tkuester/public-safety-lna/lna-filt.kicad_pcb

## KiCad design lna-filt.kicad_pcb (2020-05-25)

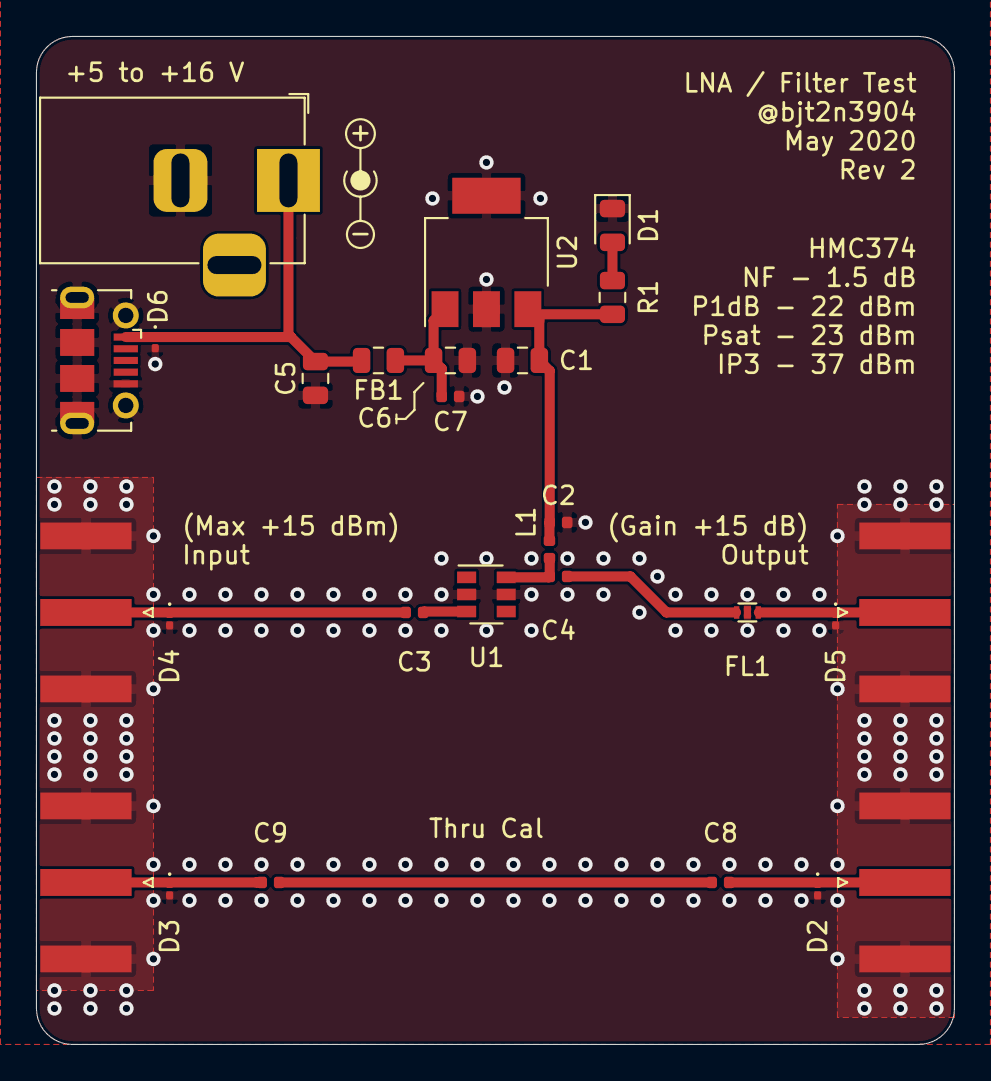
[picture p2: board lna-filt.kicad_pcb from above]

Board: 2 copper layers, 51.0 x 56.0 mm, 27 parts (0 on the bottom side), 13 nets.

Parts:
C1, C5, C6: 4.7u; C_0805_2012Metric
C2: 1n; C_0402_1005Metric
C3, C4, C8, C9: 150p; C_0402_1005Metric
C7: 100n; C_0402_1005Metric
D1: LED; LED_0805_2012Metric
D2, D3, D4, D5, D6: ESD101; D_0201_0603Metric
FB1: Ferrite_Bead_Small; R_0805_2012Metric
FL1: FI168B0845D9-T
J1, J2, J5, J6: Conn_Coaxial; SMA_Amphenol_132289_EdgeMount
J3: Barrel_Jack; BarrelJack_Horizontal
J4: USB_B_Micro; USB_Micro-B_Molex-105017-0001
L1: 27n; L_0402_1005Metric
R1: R; R_0805_2012Metric
U1: HMC374; SOT-23-6
U2: MCP1703A-3302_SOT223; SOT-223-3_TabPin2

Connections:
+3V3: C1.2, C2.2, L1.1, R1.2, U2.3
+5V: C5.2, D6.1, FB1.2, J3.1, J4.1
GND: C1.1, C2.1, C5.1, C6.1, C7.1, D1.1, D2.2, D3.2, D4.2, D5.2, D6.2, FL1.2, J1.2, J2.2, J3.2, J4.5, J4.6, J5.2, J6.2, U1.2, U1.5, U2.2
unnamed: C3.1, U1.3
unnamed: C3.2, D4.1, J1.1
unnamed: C4.1, FL1.1
unnamed: C4.2, L1.2, U1.6
unnamed: C6.2, C7.2, FB1.1, U2.1
unnamed: C8.1, C9.2
unnamed: C8.2, D2.1, J5.1
unnamed: C9.1, D3.1, J6.1
unnamed: D1.2, R1.1
unnamed: D5.1, FL1.3, J2.1
