tkuester/public-safety-lna/(threads)

Thread 1 (2020-05-25):

Fix SMA Footprint

tkuester, 2020-05-25:
* [ ] Move footprint closer to edge of PCB to remove GND sliver
* [ ] Remove thermals from GND pads
* [ ] Expose more solder mask for "eBay SMA connectors"

Closed 2020-05-25.
