tkuester/public-safety-lna/(commit log)

2020-05-25 Adding first generation of release files
    [lna-filt-B_Cu.gbr, lna-filt-B_Mask.gbr, lna-filt-B_Paste.gbr, lna-filt-B_SilkS.gbr, lna-filt-Edge_Cuts.gbr, lna-filt-F_Cu.gbr, lna-filt-F_Mask.gbr, lna-filt-F_Paste.gbr]
2020-05-25 Move LED to 3V3, add power silk screen
    Closes #2
    [lna-filt.kicad_pcb, lna-filt.sch]
2020-05-25 Removing thermals for SMA, fixing SMA short
    The SMA connectors were not close enough to the edge of the PCB. A thin
    strip of copper went under the center pin, and would short it to ground.
    By bumping the connector closer to the PCB edge, we remove the short.
    Closes #1.
    [lna-filt.kicad_pcb]
